macgeorge/STM32L4Quadcopter/README.md

# Quadcopter control board using an STM32L4 microcontroller
Hardware files
Please see https://christidis.info/index.php/personal-projects/quadcopter-controller for more details
