macgeorge/STM32L4Quadcopter/L4_Quadcopter_BOM.xlsx

Comment | Description | Designator | Footprint | LibRef | Quantity
TestPoint | Testpoint | +3V3, +5V, +5V_b, GPS, Rx, SCL, Tx | HDR1 | TestPoint | 7
Cap_100N_50V_0805 | Capacitor | C3, C4, C0103, C0104, C0201, C0401, C0502, C0503, C0504, C0505, C0506, C0507, C0508, C0509, C0601, C0701, C0901, C1001, C1002, C1003, C1004, C1005, C1009, C1101, C1105, C1106, C1201, C_nrf | 0805 C | Cap_100N_50V_0805 | 28
Cap_22u_25V_0805 | Capacitor | C0101, C0102, C0105, C0106, C0301, C0802, C1008, C1202 | 0805 C | Cap_22u_25V_0805 | 8
Cap_1N_50V_0805 | Capacitor | C0501, C0510, C0801 | 0805 C | Cap_1N_50V_0805 | 3
Cap_18p_50V_0805 | Capacitor | C0702, C0703, C1006, C1007 | 0805 C | Cap_18p_50V_0805 | 4
Diode B2100-13-F | Schottky Diode 100V 2A | D1, D2, D3 | DO214AA | Diode B2100-13-F | 3
LED Green 0805 | Typical INFRARED GaAs LED | D0101, D0201, D0301, D0401, D0501, D0701, D0702, D0801, D0901 | 0805_G_LED | LED_Green_0805 | 9
BAT54S | Schottky Barrier Double Diode | D1001, D1002, D1101, D1102, DESC_BL, DESC_BR, DESC_FL, DESC_FR | SOT23_M | BAT54S | 6
SMT32L496 | STM32L496RGTx LQFP64 | IC10 | LQFP64_M | STM32L496RGTx | 1
USB_micro | Conn USB Type B M 5 POS 0.65mm Solder RA Thru-Hole 5 Terminal 1 Port Embossed T/R | J1 | MOLEX_105017-0001 | USB_micro | 1
DM3AT-SF-PEJM5 | DM3 Series 8 Position Right Angle SMT Push Push Ejection MicroSD Card Connector | J12 | HRS_DM3AT-SF-PEJM5_DM3AT-SF-PEJM5(Primary) | DM3AT-SF-PEJM5 | 1
Ind_4u7_6.8A | Ind 4u7 6.8A | L0101 | INDM125125X800N | Ind_4u7_6.8A | 1
 | Header, 4-Pin | P2, P5 | Molex Picoblade 4way | Header 4 | 2
 | Header, 8-Pin | P3 | MPU-6050_GY87 | Header 8 | 1
Conn_JST B4B XH | Connector 4pin 2.5mm JST B4B XH | P6 | JST_B4B-XH-A(LF)(SN) | Conn_JST B4B XH | 1
 | Header, 2-Pin | P6_2, P17, P18 | HDR 1x2 | Header 2 | 3
 | Header, 3-Pin | P7, P10, P13, P14 | HDR 1x3 | Header 3 | 4
 | Header, 4-Pin, Dual row | P8 | HDR 2x4 Female | Header 4X2 | 1
Header 4X2 | Header, 4-Pin, Dual row | P9 | HDR 2x4 Female | Header 4X2 | 1
 | Header, 6-Pin | P12, P16 | Molex Picoblade 6way | Header 6 | 2
Res_2K2_0805 | Resistor | R1, R2, R0302, R0303, R0507 | 0805 R | Res_2K2_0805 | 5
Res_10K0_0805 | Resistor | R3, R5, R0103, R0304, R0801, R1102, R1104, RESCbl, RESCbr, RESCfl, RESCfr, Rnrf1, Rnrf2, RproxB, RproxF | 0805 R | Res_10K0_0805 | 15
Res_0Ohm_0805 | Resistor | R4, R1003, RGPS_1, RGPS_2 | 0805 R | Res_0Ohm_0805 | 4
Res_56K0_0805 | Resistor | R0104, R1105, R1106, R1208, R1201, R1202, R1203, R1204, R1205, R1206, R1207 | 0805 R | Res_56K0_0805 | 11
Res_560R_0805 | Resistor | R0105, R0201, R0301, R0403, R0802 | 0805 R | Res_560R_0805 | 5
Res_2m_2512 | Resistor | R0401, R0402 | 2512 R | Res_2m0_2512 | 2
Res_330R_0805 | Resistor | R0501, R0701, R0702, R0901, R1001, R1002 | 0805 R | Res_330R_0805 | 6
Res_100R_0805 | Resistor | R0502, R0503, R0504, R0505, R0506, R1103 | 0805 R | Res_100R_0805 | 6
Res_R510_0805 | Resistor | R0508, R0509, R1101 | 0805 R | Res_R510_0805 | 3
FSM8JH | Switch | S1, S3, S4 | FSM8JH | SW-PB | 3
TPS561201 | 4.5-V to 17-V Input, 1-A Synchronous Step-Down Voltage Regulator in 6-Pin SOT-23 | U01 | SOT23-6_M | TPS561201DDCR | 1
TPD3S014 | Current Limit Switch and D+/D– ESD Protection for USB Host Ports, 6-Pin SOT-23 | U02 | SOT23-6_M | TPD3S014 | 1
Power Multiplexer | Dual In / Single Out Autoswitching Power MUX, Manual / Auto Switching, Adj. Cur Limit, Switch Status, 2.8 to 5.5 V, -40 to 85 degC, 8-pin TSSOP (PW), Green (RoHS & no Sb/Br) | U03 | TSSOP8_M | TPS2115APWR | 1
INA233 | Current, Voltage I2C Monitor | U04 | TSSOP10_M | INA233 | 1
Battery Manager | Analog Front End for 3 to 5 Series Lithium-Ion Cells, -25 to 85 degC, 20-pin TSSOP (PW), Green (RoHS & no Sb/Br) | U05 | TSSOP20_M | BQ7692000PWR | 1
8kb EEPROM | 8Kbit, 400kHz, 2.5V, I2C Serial EEPROM, 5-Pin SOT-23, Extended Temperature, Tape and Reel | U06 | SOT-23-CT5_M | 24LC08BT-E/OT | 1
MCP2200-I/SS | Interface Bridges, USB to UART, 3 V, 5.5 V, SSOP, 20 Pins, -40 C | U07 | SSOP-SS20_M | MCP2200-I/SS | 1
TPS22918 | TPS22918.5-V, 2-A, 52-mΩ On-Resistance Load Switch | U08 | SOT23-6_M | TPS22918 | 1
3.3V LDO | Single Output Fast Transient Response LDO, 200 mA, Fixed 3.3 V Output, 1.7 to 5.5 V Input, with Reverse Current Protection, 5-pin SOT-23 (DBV), -40 to 85 degC, Green (RoHS & no Sb/Br) | U09 | SOT-23-CT5_M | TPS73233DBVR | 1
INA139 | High-Side Measurement Current Shunt Monitor | U11 | SOT-23-CT5_M | INA139 | 1
XTAL_12MHz | Crystal Oscillator | Y07, Y10 | HC49-US | XTAL_12MHz | 2
Thermistor |  |  |  |  | 1
