macgeorge/STM32L4Quadcopter/L4_Quadcopter_Schematic.pdf

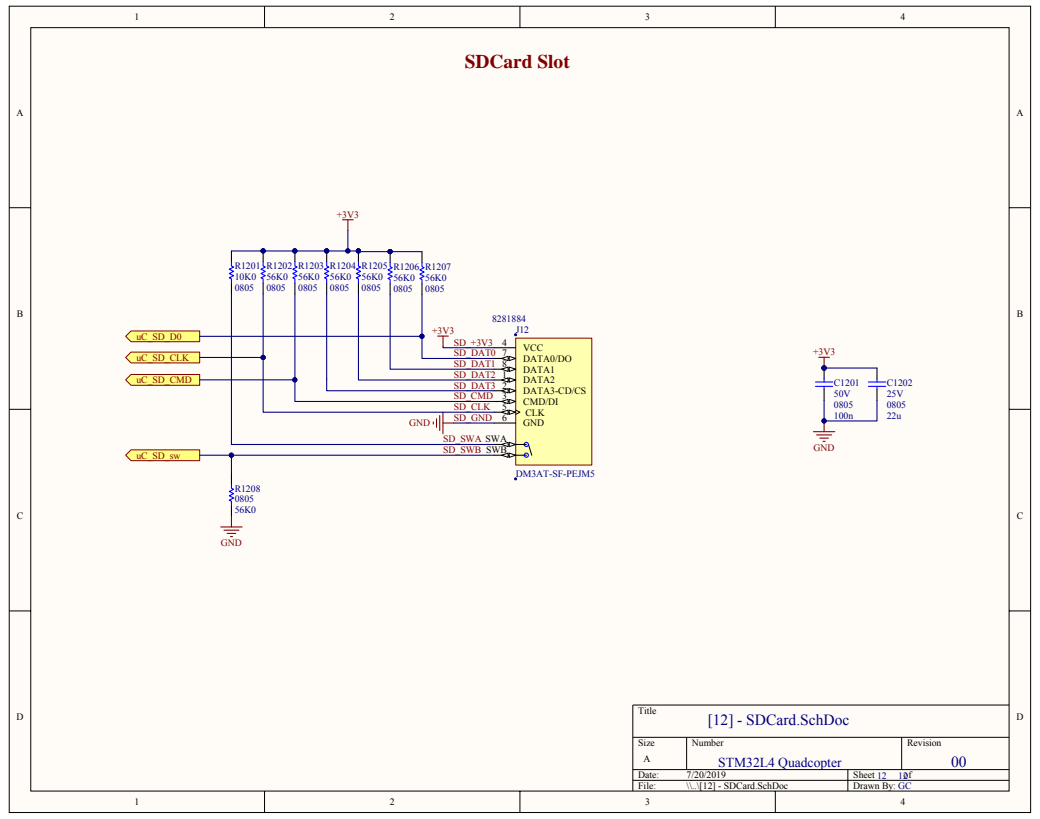
[picture p13: page 12]
