macgeorge/STM32L4Quadcopter/L4_Quadcopter_Schematic.pdf

B | B
C | C
A | A

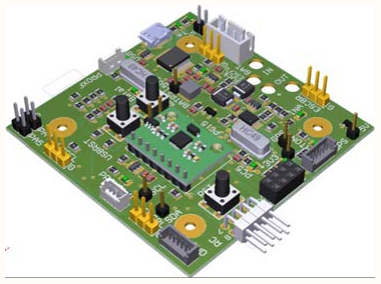
[picture p1: figure]
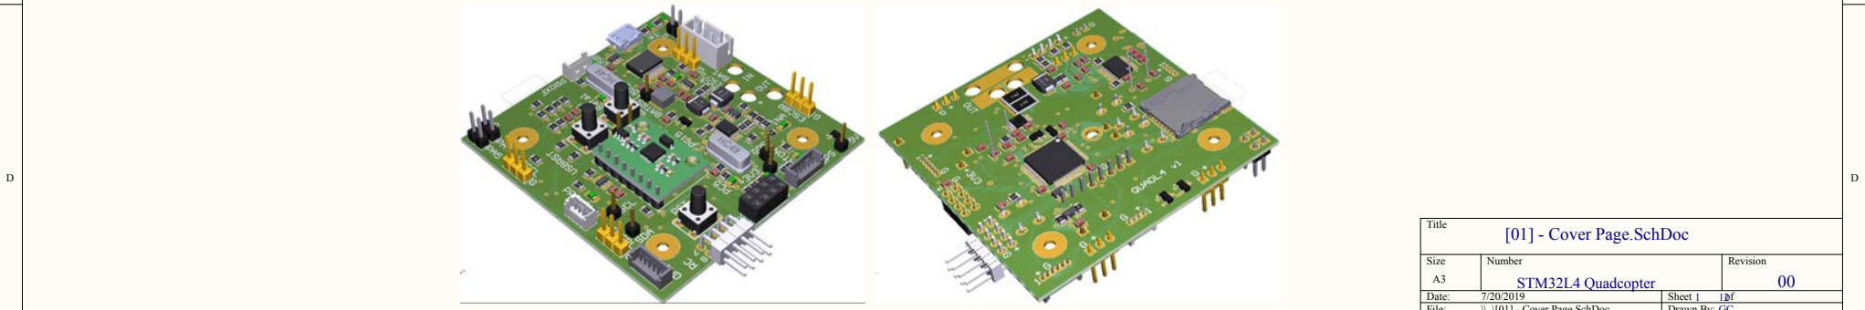
[picture p2: figure]
Title; Date: 7/20/2019; Sheet of; [01] - Cover Page.SchDoc

Size A3 | Number STM32L4 Quadcopter | Revision 00
File: \\..\[01] - Cover Page.SchDoc | Drawn By: GC

# Description: Quadcopter Control Board

7/20/2019

# Rev00

# Built on Dec-2017

## Page Index

1 | COVER PAGE
2 | CONNECTIONS: BATTERY & ESC
3 | CONNECTIONS: LOW VOLTAGE
4 | POWER: BATTERY
5 | POWER: USB
6
| uCONTROLLER: PERIPHERALS

7

## PROXIMITY SENSOR CONTROL

8

## BATTERY MONITOR

9
10

## Page Index

11
12 | SDCARD
13 | |
14 | |
15 | |
16 | |
17 | |
18 | |
19 | |
20 | |

## Page Index

21 | |
22 | |
23 | |
24 | |
25 | |
26 | |
27 | |
28 | |
29 | |
30 | |

## Page Index

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
## POWER: 3V3 REGULATOR

## uCONTROLLER: CORE

## POWER: SELECTOR

TOP VIEW | BOTTOM VIEW

# Project:STM32L4 Quadcopter

## Battery Input

## Battery Output

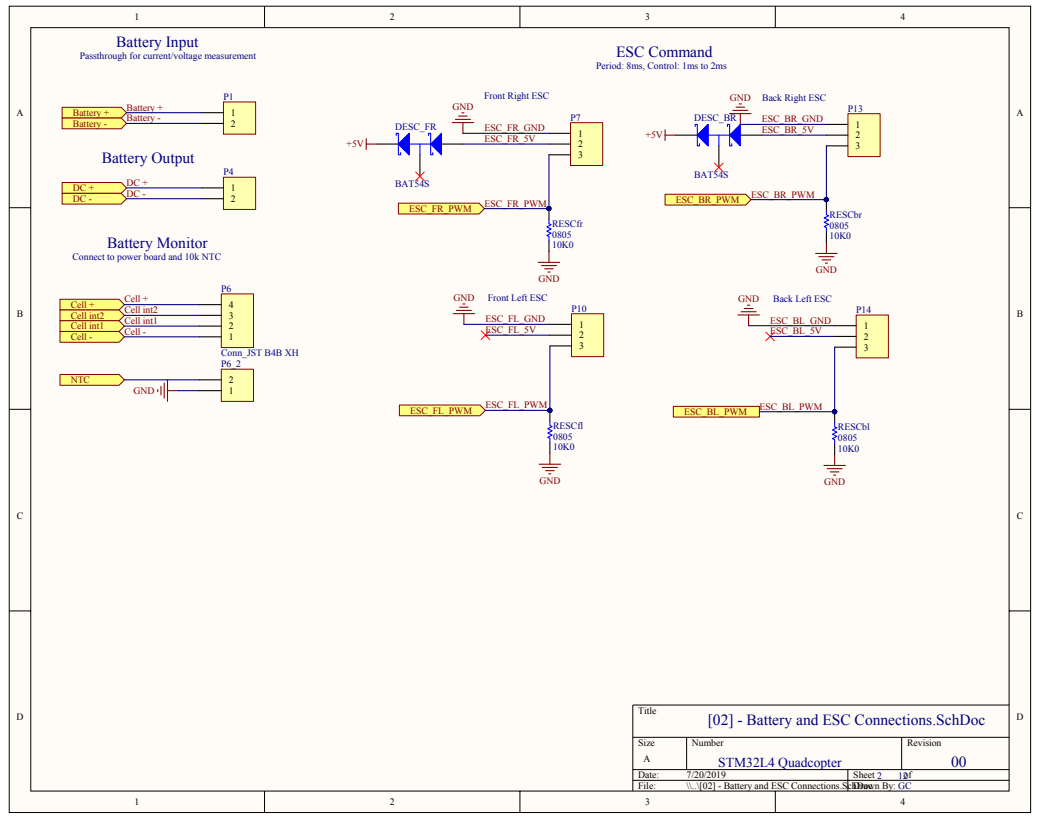
[picture p3: page 2]
Title; Size; Number; Revision; File:; \\..\[02] - Battery and ESC Connections.SchDoc Drawn By:; ESC_FR_GND ESC_FR_5V; ESC_FR_PWM; ESC_FL_GND ESC_FL_5V; ESC_FL_PWM; ESC_BR_GND ESC_BR_5V; ESC_BR_PWM; ESC_BL_GND ESC_BL_5V; ESC_BL_PWM; Battery + Battery -; Cell + Cell int2 Cell int1 Cell -; Battery Monitor; GND; NTC; DESC_FR; BAT54S; DESC_BR; Conn_JST B4B XH; RESCfr; RESCfl; RESCbr; RESCbl

ESC Command
Period: 8ms, Control: 1ms to 2ms

Passthrough for current/voltage measurement

Front Right ESC
GND

Back Right ESC

Connect to power board and 10k NTC

Front Left ESC

Back Left ESC

[02] - Battery and ESC Connections.SchDoc

## MPU Connector

## USB Mini Connector

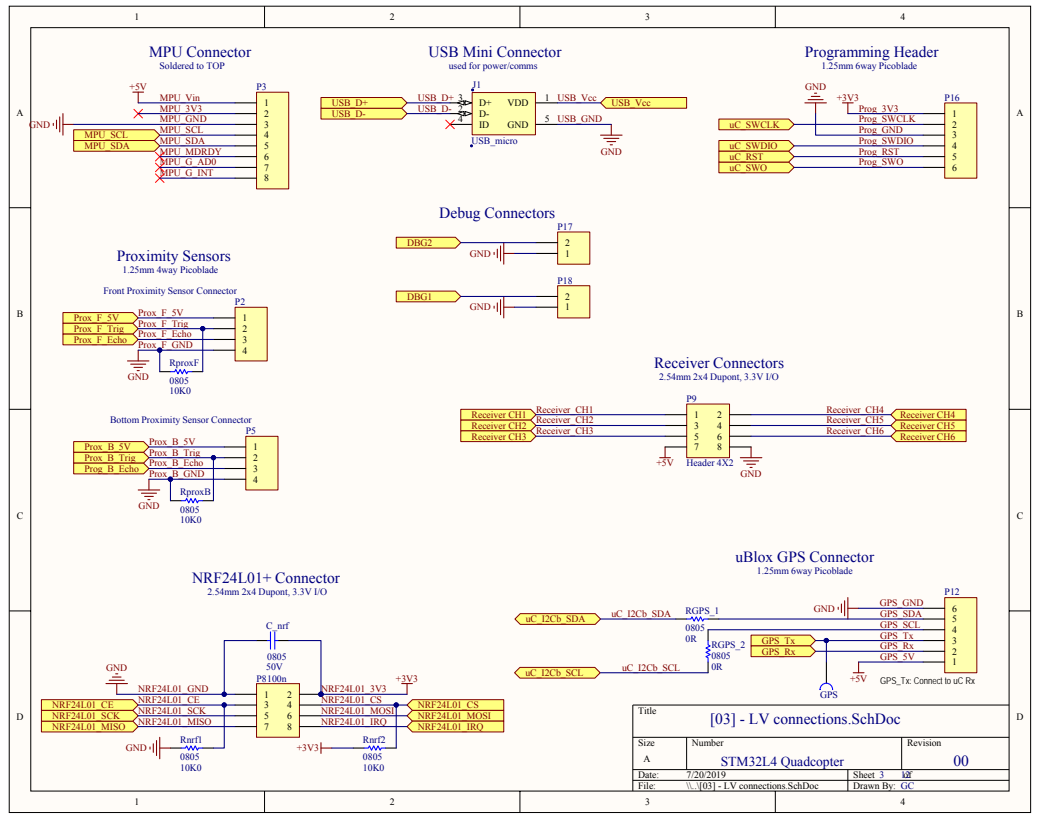
[picture p4: page 3]

Front Proximity Sensor Connector

Bottom Proximity Sensor Connector

GPS_Tx: Connect to uC Rx

## 5V regulator from Battery

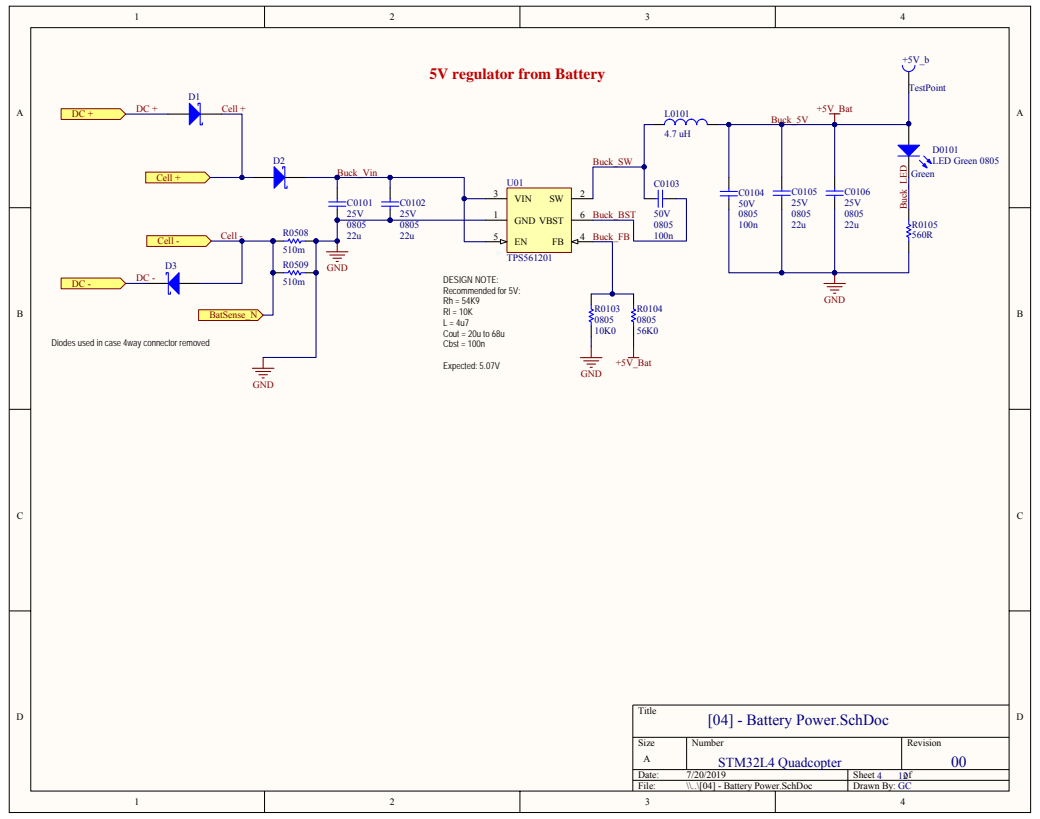
[picture p5: page 4]

Diodes used in case 4way connector removed

## USB ESD protection and current limit

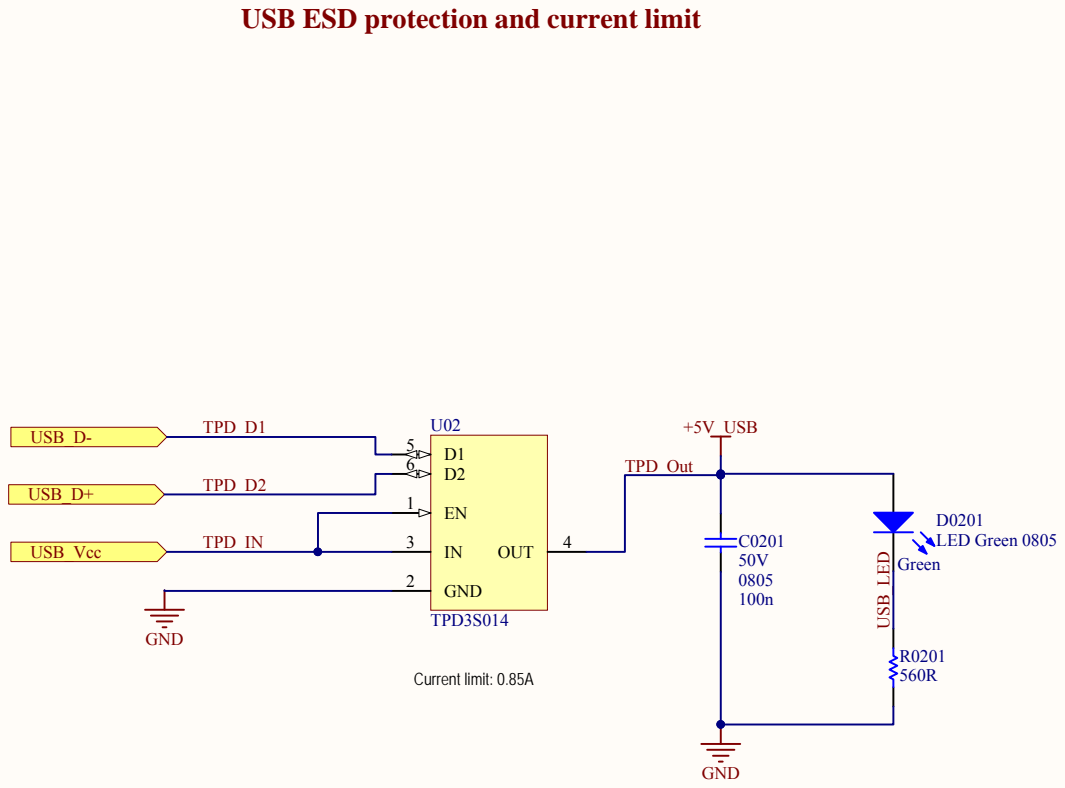
[picture p6: page 5]
Title; Size; Number; Revision; File:; \\..\[05] - USB Power.SchDoc; Drawn By:; OUT; GND 2; TPD3S014; USB_Vcc; USB_D-; USB_D+; GND; +5V_USB; TPD_D1; TPD_D2; TPD_IN; TPD_Out; Green; D0201 LED Green 0805; USB_LED50V 0805 100n; Current limit: 0.85A

[05] - USB Power.SchDoc

# LV source selector and current Measurement

## LV current measurement

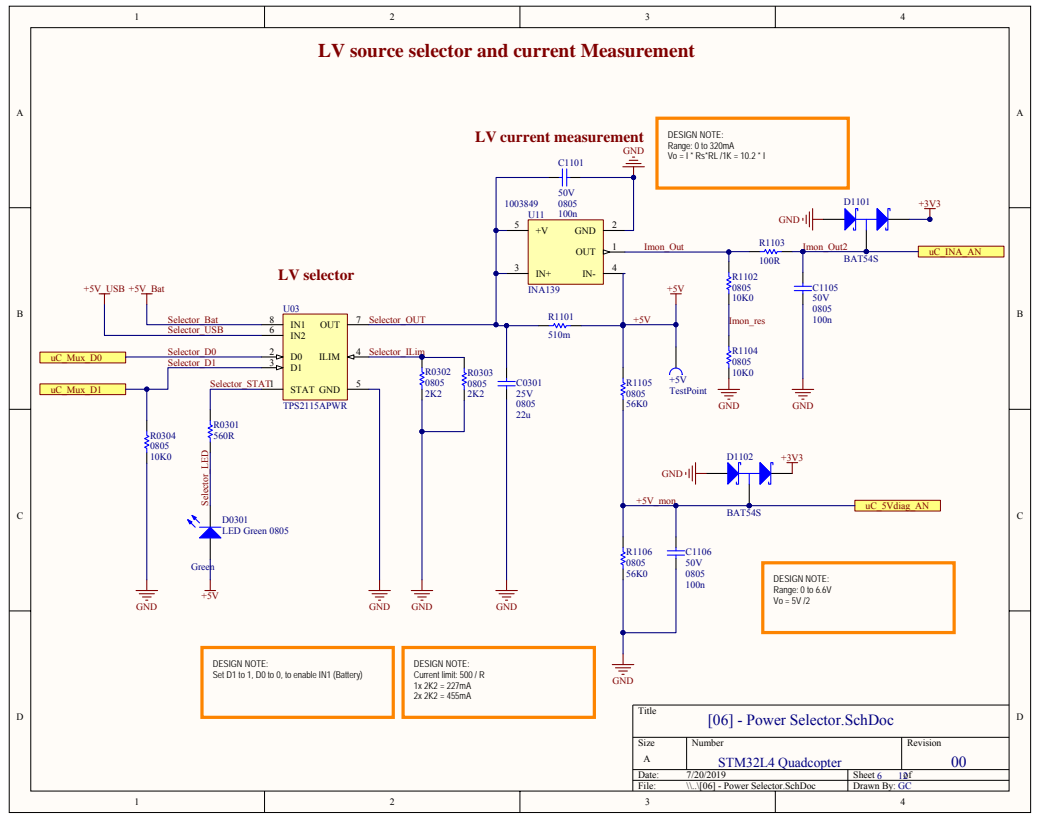
[picture p7: page 6]

DESIGN NOTE:
Set D1 to 1, D0 to 0, to enable IN1 (Battery)

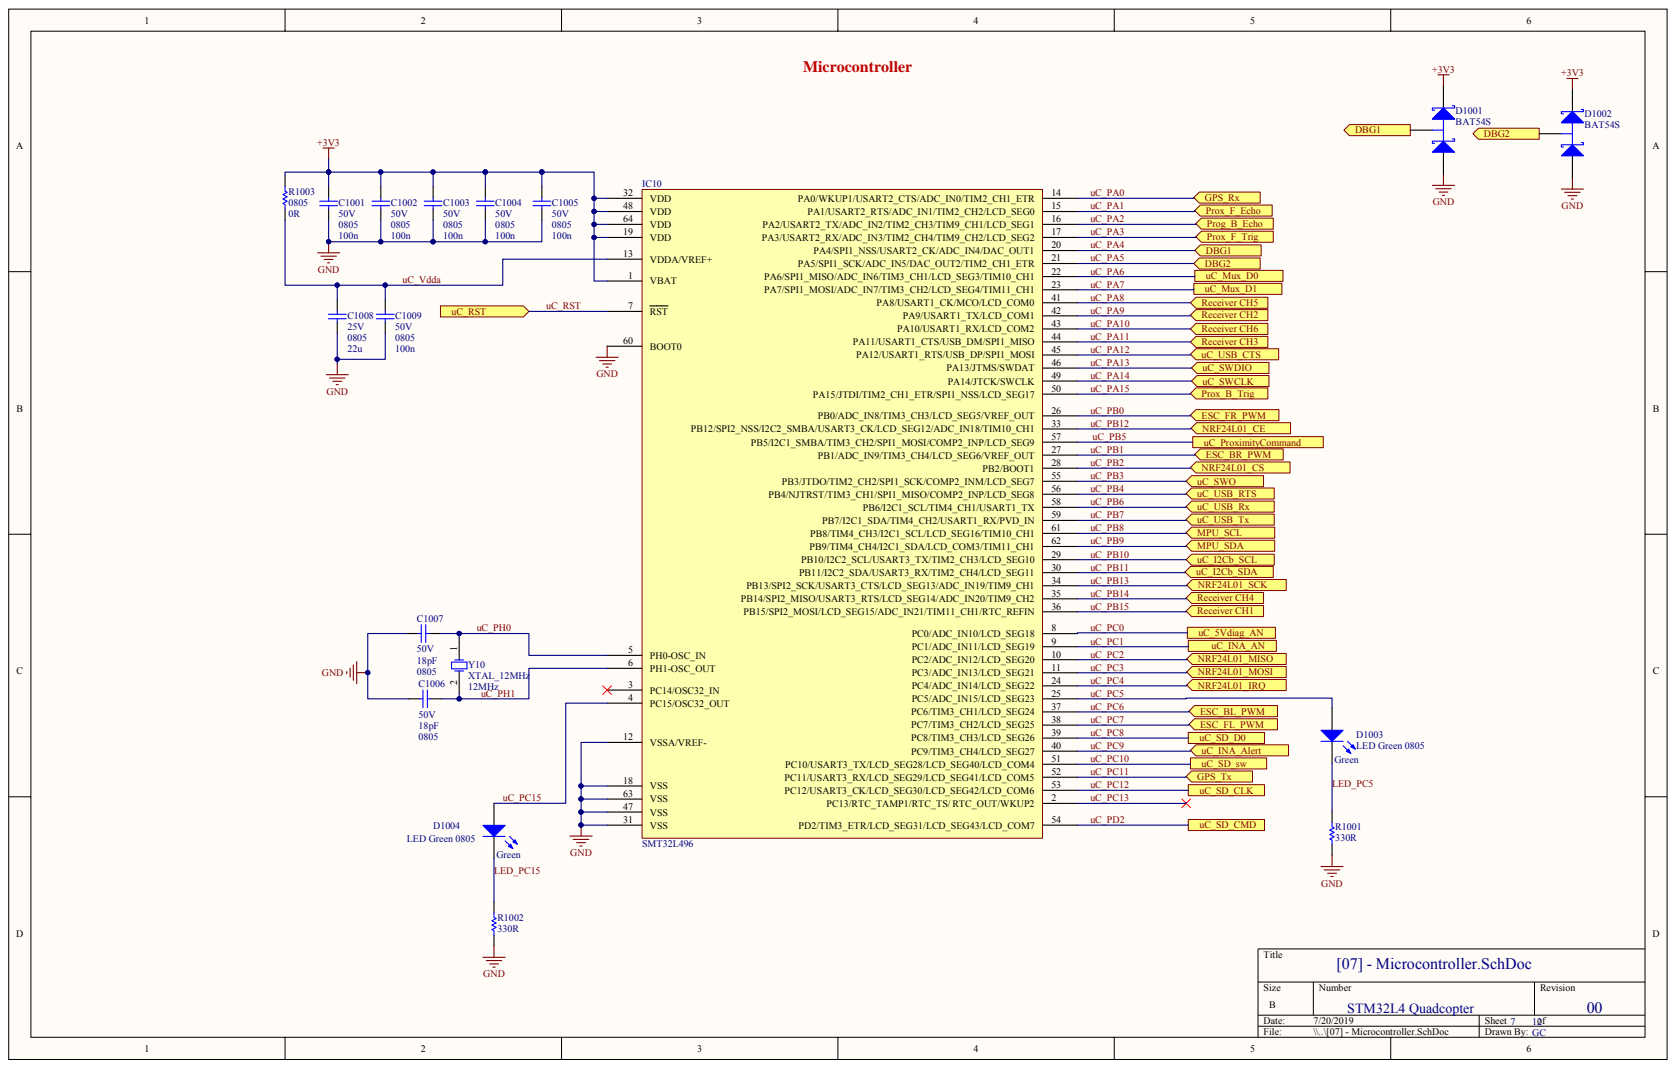
[picture p8: page 7]

Size B | Number STM32L4 Quadcopter | Revision 00

Date: 7/20/2019 | Sheet 7 12 of
File: \\..\[07] - Microcontroller.SchDoc | Drawn By:

# Microcontroller Peripherals

I2Cb pullups | Reset | 8kbit I2C EEPROM

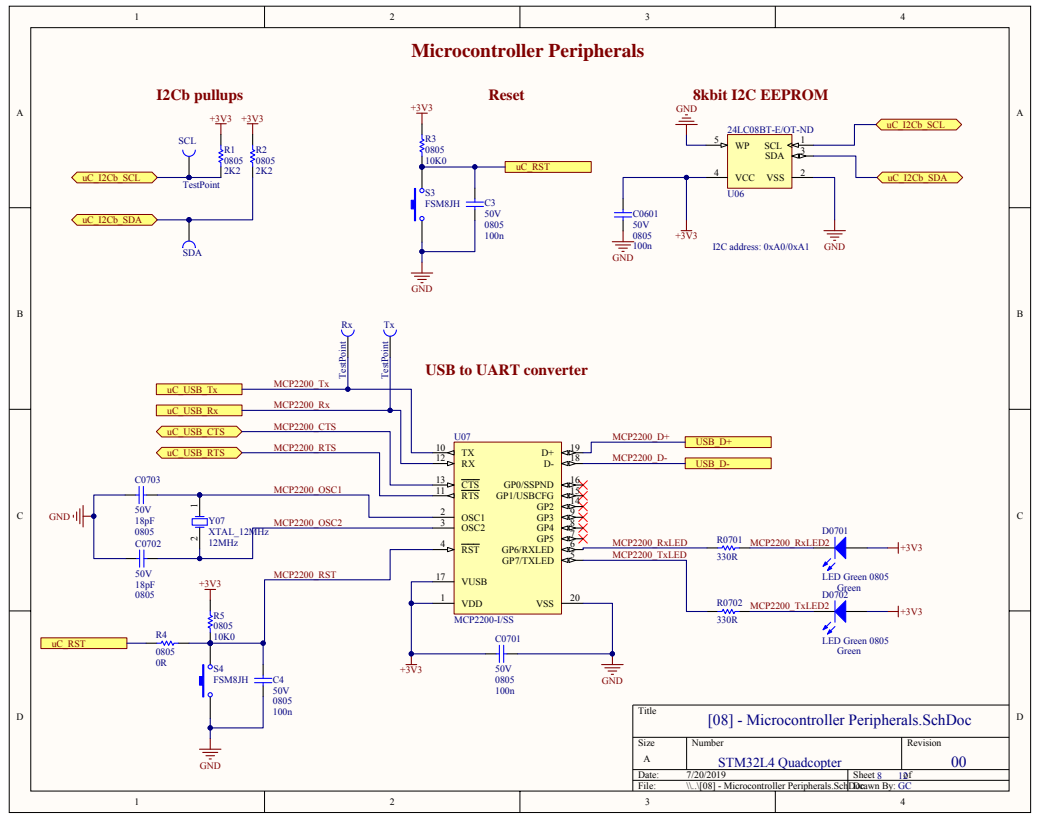
[picture p9: page 8]

TestPoint
USB to UART converter

# Proximity Sensors Switch

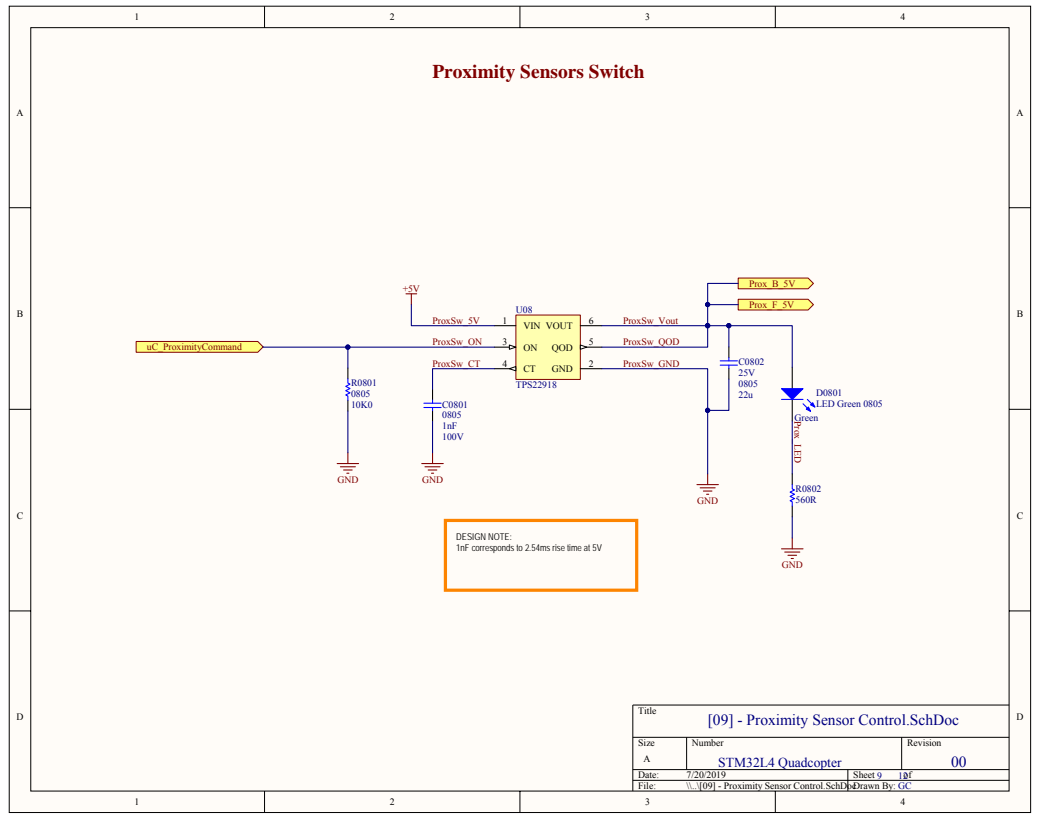
[picture p10: page 9]
Title; Size; Number; Revision; File:; \\..\[09] - Proximity Sensor Control.SchDocDrawn By:; GND; Prox_B_5V; Prox_F_5V; VOUT; VIN 1; QOD; TPS22918; uC_ProximityCommand; ProxSw_ON; ProxSw_QOD; ProxSw_CT; ProxSw_5V; ProxSw_GND; ProxSw_Vout; Green; D0801 LED Green 0805; Prox_LED

DESIGN NOTE:
1nF corresponds to 2.54ms rise time at 5V

[09] - Proximity Sensor Control.SchDoc

# Battery Power/Energy Measurement, Monitor and Balancer

## Battery Energy Measurement

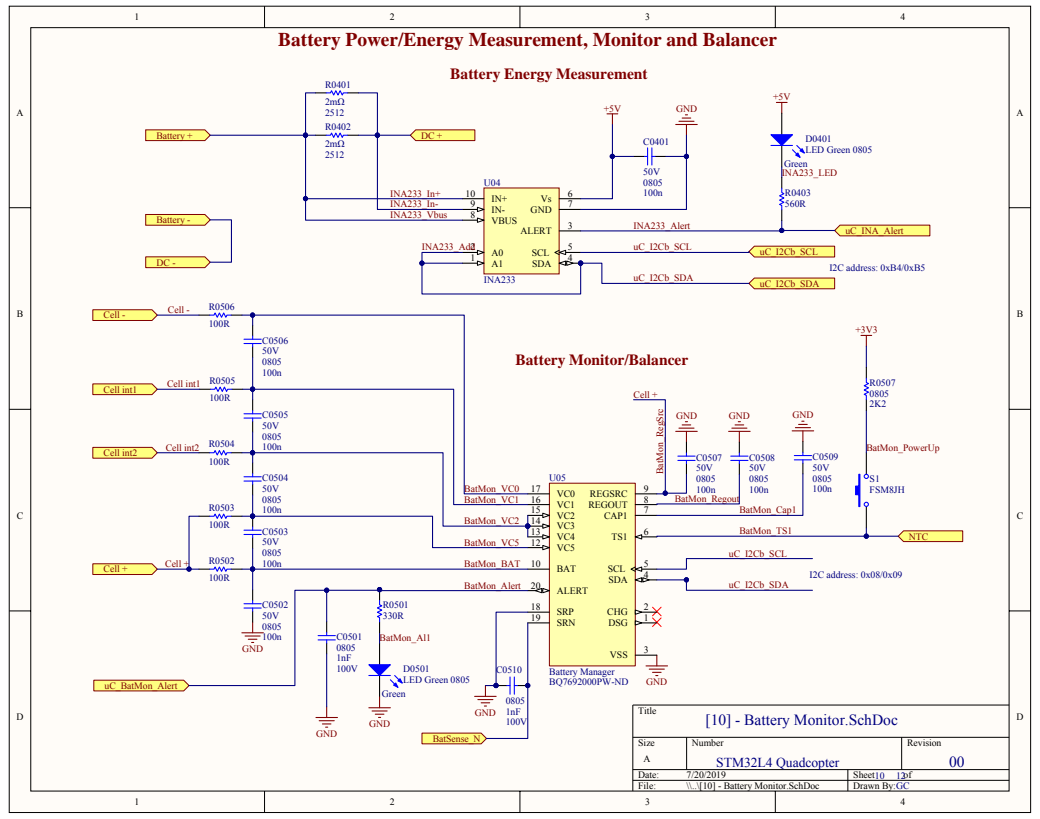
[picture p11: page 10]

# 3V3 Regulator

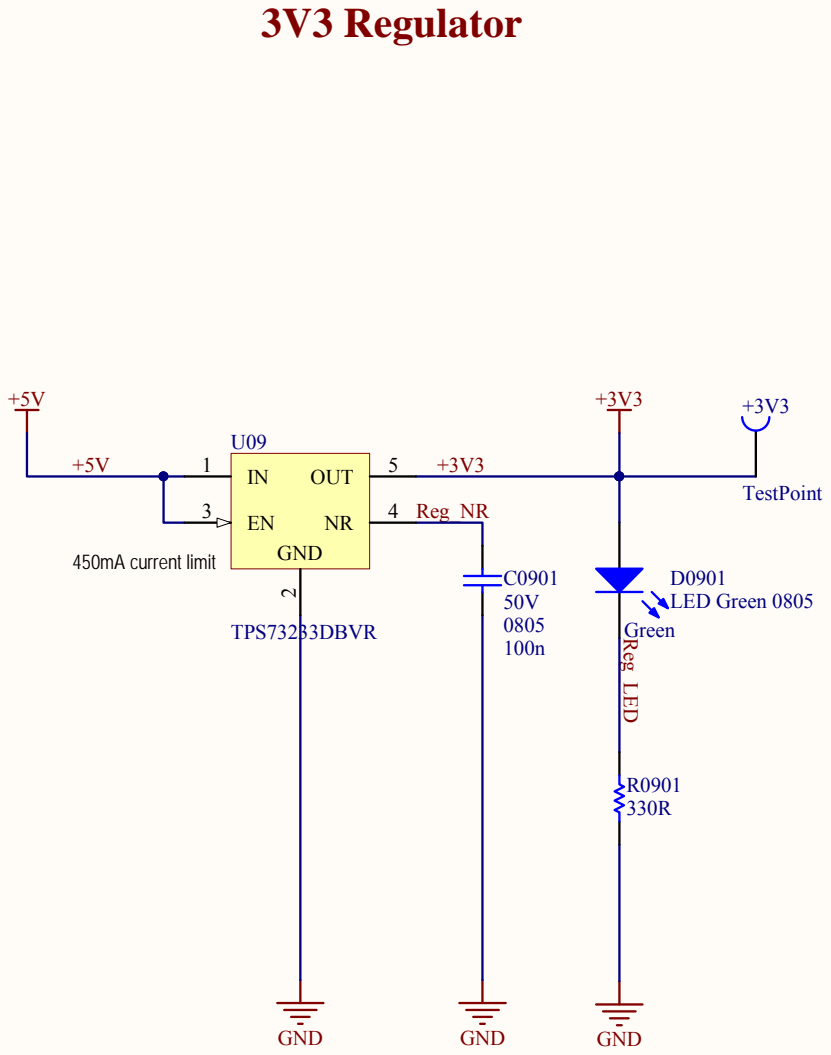
[picture p12: page 11]
Title; Size; Number; Revision; File:; \\..\[11] - 3V3 Regulator.SchDoc; Drawn By:; GND; Green; D0901 LED Green 0805; Reg_NR; Reg_LED; TPS73233DBVR; OUT; 450mA current limit; TestPoint; [11] - 3V3 Regulator.SchDoc

# SDCard Slot
